OpenSourceSDRLab/WaveSentry/WaveSentry_Community/README.md

# Version Description

There are two versions of WaveSentry. One is WaveSentry and the other one is WaveSentry Pro. The only difference between WaveSentry and WaveSentry Pro is the thermal imaging. Because the WaveSentry Pro has a thermal imaging camera. 

- WaveSentry includes the functions of Radio Receiver, WiFi and Bluetooth Analysis.
- WaveSentry Pro includes the functions of Radio Receiver, WiFi and Bluetooth Analysis, Thermal Imaging.

The WaveSentry_Community is the folder of the source code for WaveSentry, not WaveSentry Pro.
