OpenSourceSDRLab/WaveSentry/images/WaveSentry-back.jpg

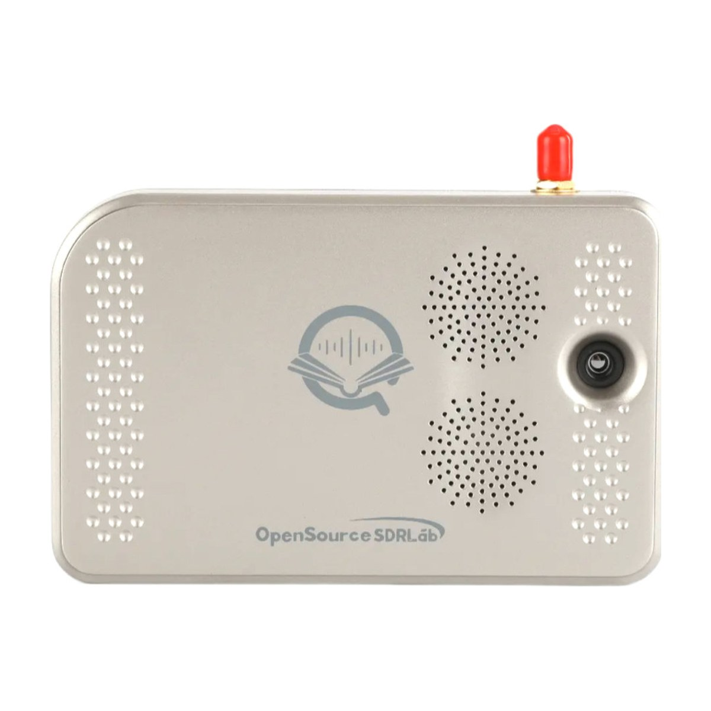
images/WaveSentry-back.jpg
