OpenSourceSDRLab/WaveSentry/images/WaveSentry-front.jpg

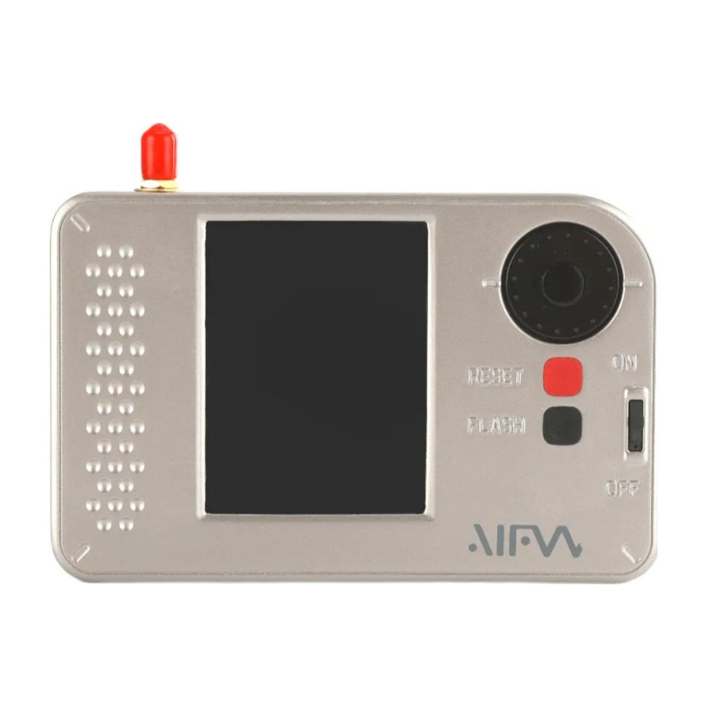
images/WaveSentry-front.jpg
