OpenSourceSDRLab/WaveSentry/images/WaveSentry-side.jpg

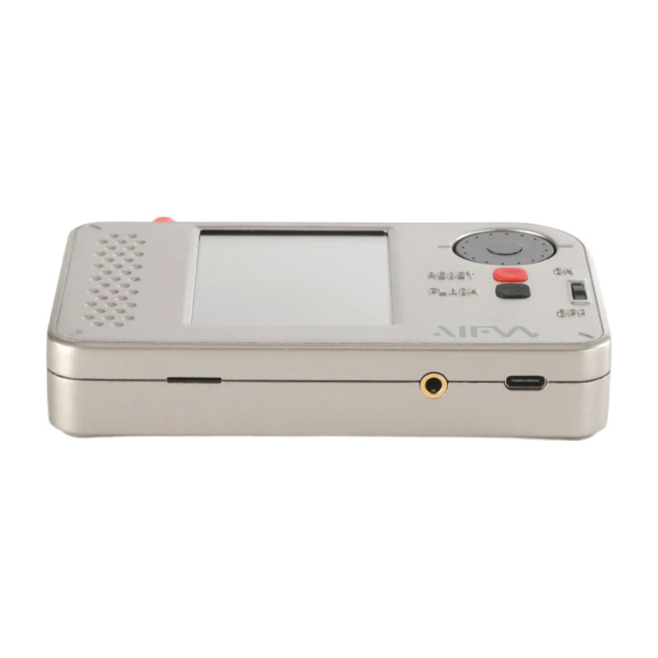
images/WaveSentry-side.jpg
