OpenSourceSDRLab/WaveSentry/images/WaveSentry-Youtube-1.jpg

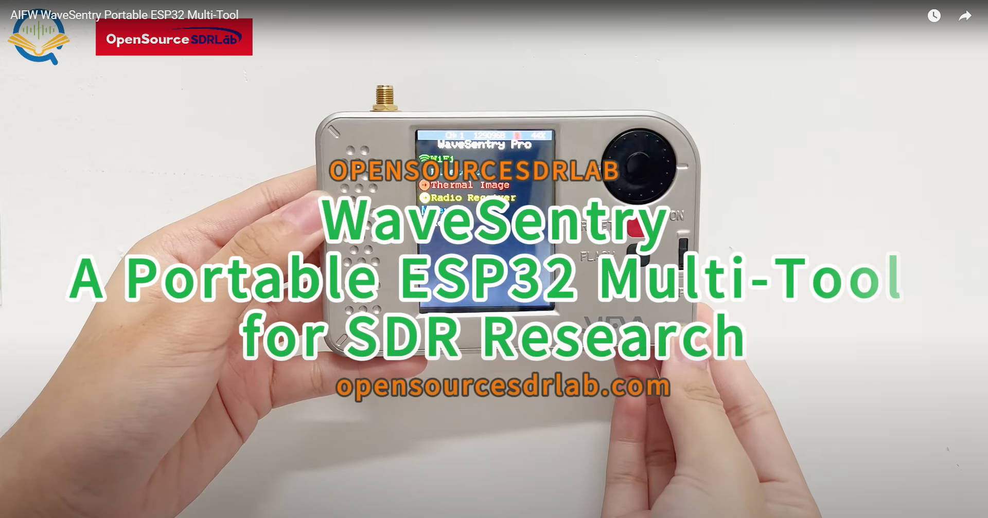
images/WaveSentry-Youtube-1.jpg
