OpenSourceSDRLab/WaveSentry/hardware/WaveSentry_Schematic.pdf

## © 2026 OpenSourceSDRLab. All rights reserved. · www.opensourcesdrlab.com

## OPENSOURCESDRLAB DOCUMENTATION

# WaveSentry Schematic

Product | WaveSentry
Document | OSSDRLAB-WaveSentry-SCH
Version | 1.0
Date | 2026-11-12

This document contains the circuit schematic of the OpenSourceSDRLab WaveSentry and WaveSentry Pro (two A4 sheets). The sheets follow this cover page.

Sheet | Content
1 | MCU: ESP32-WROOM-32E module, USB-C with CP2102 USB-UART bridge and auto-reset, 2.8-inch ILI9341 TFT connector with XPT2046 touch controller, microSD socket, rotary encoder and buttons, MLX90640 thermal camera (WaveSentry Pro), 24LC16 EEPROM, 12-pin expansion header (I2C, UART, GPS)
2 | Audio, radio and power: SI4732 AM/FM receiver with antenna input, NS4160 audio amplifier and speaker connector, 3.5 mm headphone jack with mute switch, BQ24075 battery charger, MAX17055 fuel gauge, ME6217 3.3 V regulators, power switch and battery connector

# Product page: https://opensourcesdrlab.com/products/aifw-wavesentry-esp32

# Questions about the hardware: support@opensourcesdrlab.com

RXD0 | RXD⁰ TXD⁰DTR | RTS

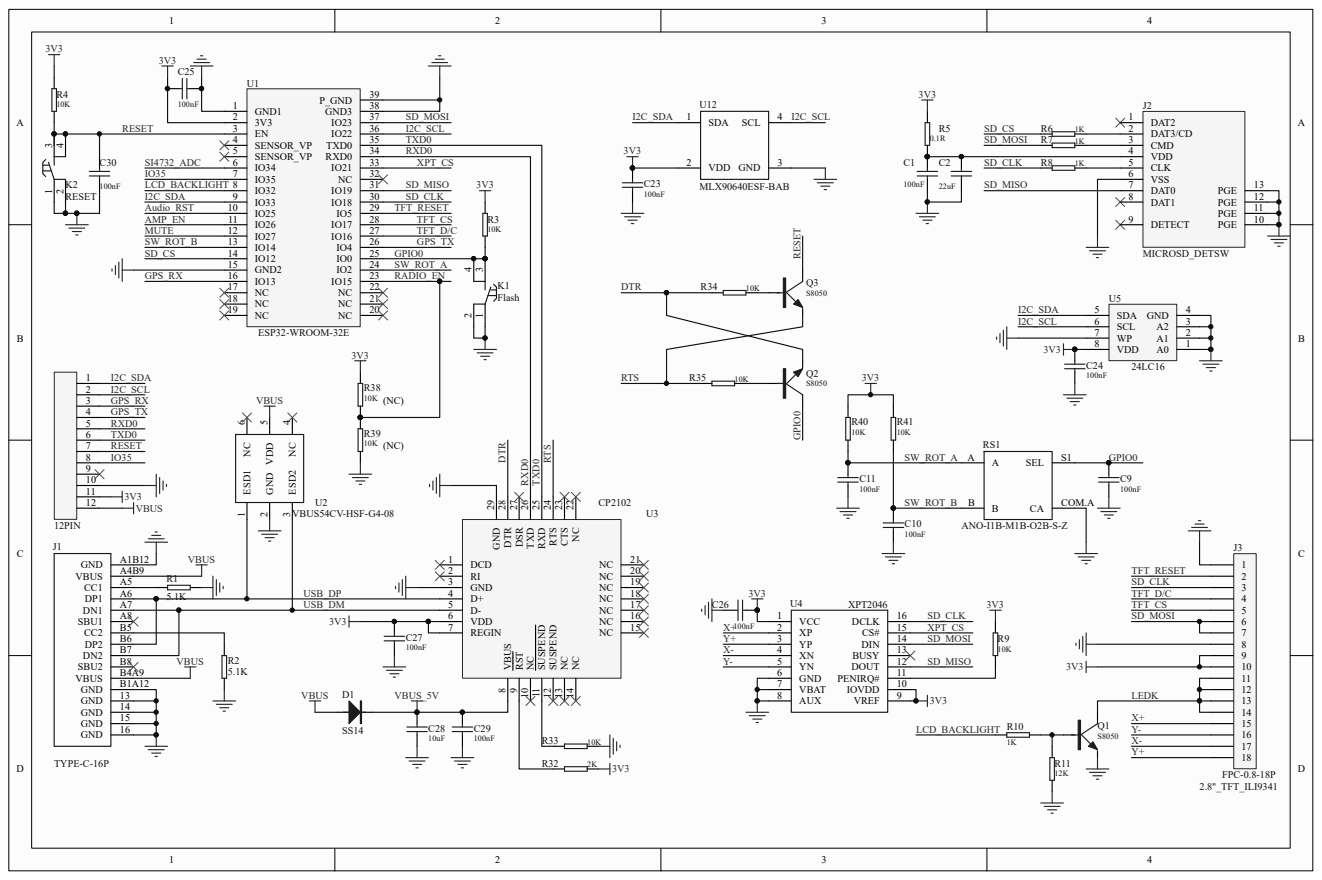
[picture p11: page 2]

9 NC 10 SUSPEND 11 SUSPEND 12 NC 13 NC 14

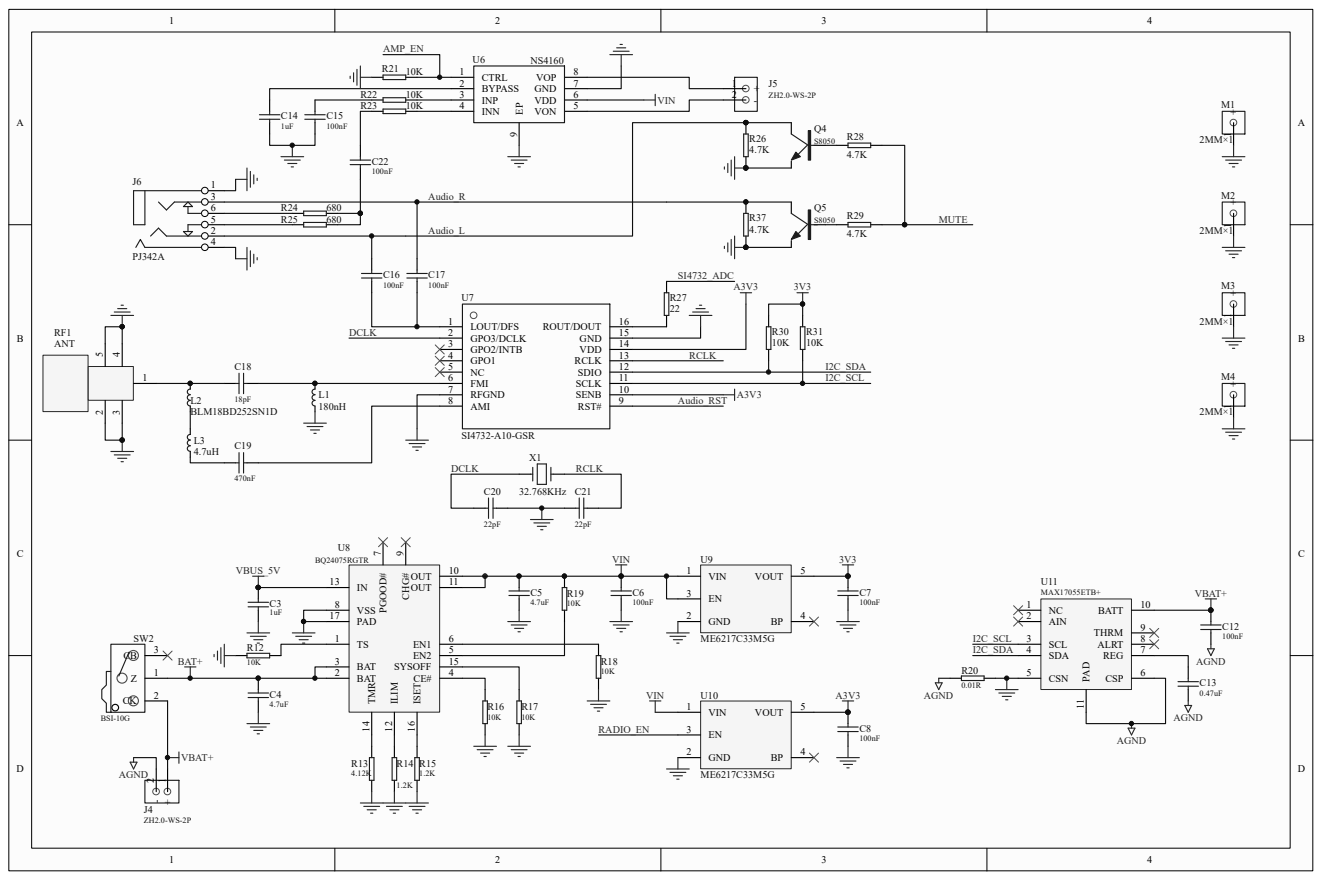
[picture p12: page 3]
