OpenSourceSDRLab/WaveSentry/hardware/WaveSentry_MCU_SchDoc.pdf

RXD0 | RXD⁰ TXD⁰DTR | RTS


9 NC 10 SUSPEND 11 SUSPEND 12 NC 13 NC 14
