OpenSourceSDRLab/WaveSentry/WaveSentry-V2.0/src/wavesentry_community.ino

/* FLASH SETTINGS
Board: LOLIN D32
Flash Frequency: 80MHz
Partition Scheme: Minimal SPIFFS
https://www.online-utility.org/image/convert/to/XBM
*/

#include "configs.h"

#ifndef HAS_SCREEN
  #define MenuFunctions_h
  #define Display_h
#endif

#include <WiFi.h>
#include <Wire.h>
#include "esp_wifi.h"
#include "esp_wifi_types.h"
#include <stdio.h>
#include "freertos/FreeRTOS.h"
#include "freertos/task.h"
#include "esp_system.h"
#include <Arduino.h>

#ifdef HAS_GPS
  #include "GpsInterface.h"
#endif

#include "Assets.h"
#include "WiFiBleScan.h"
#ifdef HAS_SD
  #include "SDInterface.h"
#endif
#include "Buffer.h"

#include "settings.h"
#include "CommandLine.h"
#include "lang_var.h"

#ifdef HAS_BATTERY
  #include "BatteryInterface.h"
#endif

#ifdef HAS_SCREEN
  #include "Display.h"
  #include "MenuFunctions.h"
#endif

#ifdef HAS_BUTTONS
  #include "Switches.h"
  
  #if (U_BTN >= 0)
    Switches u_btn = Switches(U_BTN, 1000, U_PULL);
  #endif
  #if (D_BTN >= 0)
    Switches d_btn = Switches(D_BTN, 1000, D_PULL);
  #endif
  #if (L_BTN >= 0)
    Switches l_btn = Switches(L_BTN, 1000, L_PULL);
  #endif
  #if (R_BTN >= 0)
    Switches r_btn = Switches(R_BTN, 1000, R_PULL);
  #endif
  #if (C_BTN >= 0)
    Switches c_btn = Switches(C_BTN, 1000, C_PULL);
  #endif

#endif

#include "Rotary.h"
volatile int encoderCount = 0;
Rotary encoder = Rotary(ENCODER_PIN_A, ENCODER_PIN_B);

WiFiBleScan wifi_ble_scan_obj;
Buffer buffer_obj;
Settings settings_obj;
CommandLine cli_obj;

#ifdef HAS_GPS
  GpsInterface gps_obj;
#endif

#ifdef HAS_BATTERY
  BatteryInterface battery_obj;
#endif

#ifdef HAS_SCREEN
  Display display_obj;
  MenuFunctions menu_function_obj;
#endif

#ifdef HAS_SD
  SDInterface sd_obj;
#endif

RadioReceiver radio_obj;


const String PROGMEM version_number = FIRMWARE_VERSION;

uint32_t currentTime  = 0;

lv_area_t g_btn_cont_area;
bool g_limit_to_container = false;

lv_disp_drv_t disp_drv;
lv_disp_t* g_disp = NULL;

void backlightOn() {
  #ifdef HAS_SCREEN
      digitalWrite(TFT_BL, HIGH);
  #endif
}

void backlightOff() {
  #ifdef HAS_SCREEN  
      digitalWrite(TFT_BL, LOW);
  #endif
}

void  rotaryEncoder()
{ // rotary encoder events
  uint8_t encoderStatus = encoder.process();
  if (encoderStatus)
  {
    encoderCount = (encoderStatus == DIR_CW) ? 1 : -1;
    radio_obj.rotary_encoder = encoderCount;
  }
}

void setup()
{

  pinMode(ENCODER_PIN_A, INPUT_PULLUP);
  pinMode(ENCODER_PIN_B, INPUT_PULLUP);


  // controlling encoder via interrupt
  attachInterrupt(digitalPinToInterrupt(ENCODER_PIN_A), rotaryEncoder, CHANGE);
  attachInterrupt(digitalPinToInterrupt(ENCODER_PIN_B), rotaryEncoder, CHANGE);
  
  #ifdef HAS_SCREEN
    pinMode(TFT_BL, OUTPUT);
  #endif
  
  backlightOff();
/*#if BATTERY_ANALOG_ON == 1
  pinMode(BATTERY_PIN, OUTPUT);
  pinMode(CHARGING_PIN, INPUT);
#endif*/
  
  // Preset SPI CS pins to avoid bus conflicts
  #ifdef HAS_SCREEN
    digitalWrite(TFT_CS, HIGH);
  #endif
  
  #ifdef HAS_SD
    pinMode(SD_CS, OUTPUT);

    delay(10);
  
    digitalWrite(SD_CS, HIGH);

    delay(10);
  #endif

  
  pinMode(14, INPUT); //by s, pin14 if no any mode is set, the rot-b is normal
  pinMode(2, INPUT); 
      

  Serial.begin(115200);

  while(!Serial)
    delay(10);

  Serial.println("ESP-IDF version is: " + String(esp_get_idf_version()));

  #ifdef HAS_SCREEN
    display_obj.RunSetup();
    display_obj.tft.setTextColor(TFT_WHITE, TFT_BLACK);
  #endif

  backlightOff();


  #ifdef HAS_SCREEN
    display_obj.tft.drawCentreString("WaveSentry", TFT_WIDTH/2, TFT_HEIGHT * 0.33, 1);
    display_obj.tft.drawCentreString("Community", TFT_WIDTH/2, TFT_HEIGHT * 0.5, 1);
    display_obj.tft.drawCentreString(display_obj.version_number, TFT_WIDTH/2, TFT_HEIGHT * 0.66, 1);
  #endif



  backlightOn(); // Need this

  #ifdef HAS_SCREEN
    //delay(2000);

    // Do some stealth mode stuff
    #ifdef HAS_BUTTONS
      if (c_btn.justPressed()) {
        display_obj.headless_mode = true;

        backlightOff();

        Serial.println("Headless Mode enabled");
      }
    #endif
  #endif

  settings_obj.begin();

  wifi_ble_scan_obj.RunSetup();

  //#ifdef HAS_SCREEN
  //  display_obj.tft.println(F(text_table0[2]));
  //#endif

  buffer_obj = Buffer();
  #if defined(HAS_SD)
    // Do some SD stuff
    if(sd_obj.initSD()) {
      #ifdef HAS_SCREEN
        //display_obj.tft.println(F(text_table0[3]));
      #endif
    } else {
      Serial.println(F("SD Card NOT Supported"));
      #ifdef HAS_SCREEN
        //display_obj.tft.setTextColor(TFT_RED, TFT_BLACK);
        //display_obj.tft.println(F(text_table0[4]));
        //display_obj.tft.setTextColor(TFT_CYAN, TFT_BLACK);
      #endif
    }
  #endif

  lv_init();

  static lv_color_t buf1[LV_HOR_RES_MAX * 10];  // 10-line buffer
  static lv_disp_buf_t disp_buf;
  lv_disp_buf_init(&disp_buf, buf1, NULL, LV_HOR_RES_MAX * 10);

  /* Register the display driver */
  
  lv_disp_drv_init(&disp_drv);

  disp_drv.flush_cb = my_disp_flush;  // Flush callback
  disp_drv.buffer = &disp_buf;
  disp_drv.hor_res = 240;  // Screen width
  disp_drv.ver_res = 320;  // Screen height
  g_disp = lv_disp_drv_register(&disp_drv); 
  
  lv_disp_drv_register(&disp_drv);

  lv_indev_drv_t indev_drv;
  lv_indev_drv_init(&indev_drv);             
  indev_drv.type = LV_INDEV_TYPE_POINTER;    
  indev_drv.read_cb = my_touchpad_read;      
  lv_indev_drv_register(&indev_drv);   


  #ifdef HAS_SCREEN
    display_obj.tft.setTextColor(TFT_GREEN, TFT_BLACK);
    display_obj.tft.drawCentreString("Initializing...", TFT_WIDTH/2, TFT_HEIGHT * 0.82, 1);
  #endif

  radio_obj.RunSetup();

  #ifdef HAS_BATTERY
    battery_obj.RunSetup();
  #endif
  
  #ifdef HAS_SCREEN
    //display_obj.tft.println(F(text_table0[5]));
  #endif

  #ifdef HAS_SCREEN
    //display_obj.tft.println(F(text_table0[6]));
  #endif

  #ifdef HAS_BATTERY
    battery_obj.battery_level = battery_obj.getBatteryLevel();
  #endif

  #ifdef HAS_GPS
    gps_obj.begin();
    //#ifdef HAS_SCREEN
      //if (gps_obj.getGpsModuleStatus())
        //display_obj.tft.println("GPS Module connected");
      //else
        //display_obj.tft.println("GPS Module NOT connected");
    //#endif
  #endif

  #ifdef HAS_SCREEN
    //display_obj.tft.println(F(text_table0[8]));
  
    display_obj.tft.setTextColor(TFT_WHITE, TFT_BLACK);
  
    //delay(2000);
  #endif

  #ifdef HAS_SCREEN
    menu_function_obj.RunSetup();
  #endif

  wifi_ble_scan_obj.StartScan(WIFI_SCAN_OFF);
  
  Serial.println(F("CLI Ready"));
  cli_obj.RunSetup();
}


void loop()
{ 
  lv_task_handler();
  currentTime = millis();
  bool mini = false;

  #ifdef SCREEN_BUFFER
    mini = true;
  #endif


  #ifdef HAS_BUTTONS

    if (c_btn.isHeld()) {
      wifi_ble_scan_obj.channelHop();
      while (!c_btn.justReleased())
        delay(1);
    }
  #endif


  // Update all of our objects
  /*#ifdef HAS_SCREEN
    bool do_draw = display_obj.draw_tft;
  #else
    bool do_draw = false;
  #endif*/
  
  //if ((!do_draw) && (wifi_ble_scan_obj.currentScanMode != ESP_UPDATE))
  //{
  cli_obj.main(currentTime);
  #ifdef HAS_SCREEN
    display_obj.main(wifi_ble_scan_obj.currentScanMode);
  #endif
  wifi_ble_scan_obj.main(currentTime);

  #ifdef HAS_GPS
    gps_obj.main();
  #endif
  
  // Detect SD card
  #if defined(HAS_SD)
    sd_obj.main();
  #endif
  
  if (radio_obj.scanning == true)
  {
    radio_obj.main();
  }
  
  // Save buffer to SD and/or serial
  buffer_obj.save();

  #ifdef HAS_BATTERY
    battery_obj.main(currentTime);
    //temp_obj.main(currentTime);
  #endif
  settings_obj.main(currentTime);
  if (((wifi_ble_scan_obj.currentScanMode != WIFI_PACKET_MONITOR) && (wifi_ble_scan_obj.currentScanMode != WIFI_SCAN_EAPOL)) ||
      (mini)) {
    #ifdef HAS_SCREEN
      menu_function_obj.main(currentTime);
    #endif
    //cli_obj.main(currentTime);
  }

  //if (wifi_ble_scan_obj.currentScanMode == OTA_UPDATE)
  //  web_obj.main();
  #ifdef HAS_SCREEN
    delay(1);
  #else
    delay(50);
  #endif
  //}
  /*else if (wifi_ble_scan_obj.currentScanMode == ESP_UPDATE) {
    #ifdef HAS_SCREEN
      display_obj.main(wifi_ble_scan_obj.currentScanMode);
      menu_function_obj.main(currentTime);
    #endif
    
    //cli_obj.main(currentTime);
    delay(1);
  }*/
}
