OpenSourceSDRLab/WaveSentry/(commit log)

2025-09-09 Add files via upload
    WaveSentry open source schematic
2026-11-13 Align with the OpenSourceSDRLab repository format
    Add the LVGL firmware sources from the WaveSentry-V2.0 branch as WaveSentry-V2.0/
    (Chinese comments translated), merge the two schematic sheets into one PDF with a
    cover page, white-background product photos, README, NOTICE.md (ESP32 Marauder,
    SI4735, Rotary), Quick Start Guide (md + pdf), official Apache-2.0 text.
